mostafashaaban6767/Smart-Greenhouse-GroupA4/data/values used for calibration/DHT11.csv

real_temp | before_calibration_temp
8 | 10.5
26.7 | 27.6
26 | 26.2
