mostafashaaban6767/Smart-Greenhouse-GroupA4/data/values used for calibration/HX711.csv

raw | real_grams
-334720 | 0
-291830 | 109
-238760 | 226
-116510 | 566
