mostafashaaban6767/Smart-Greenhouse-GroupA4/data/values used for calibration/LDR.csv

raw_adc | real_lux
626 | 190
900 | 2400
341 | 10
600 | 90
