mostafashaaban6767/Smart-Greenhouse-GroupA4/data/values used for calibration/Soil Moisture.csv

raw_adc | real_wet_percentage
1006 | 0
602.5 | 100
