mostafashaaban6767/Smart-Greenhouse-GroupA4/data/values used for calibration/YF-S201.csv

total_pulses_to_fill_0.4L
152
142
165
