mostafashaaban6767/Smart-Greenhouse-GroupA4/docs/Greenhouse_Schematic.pdf

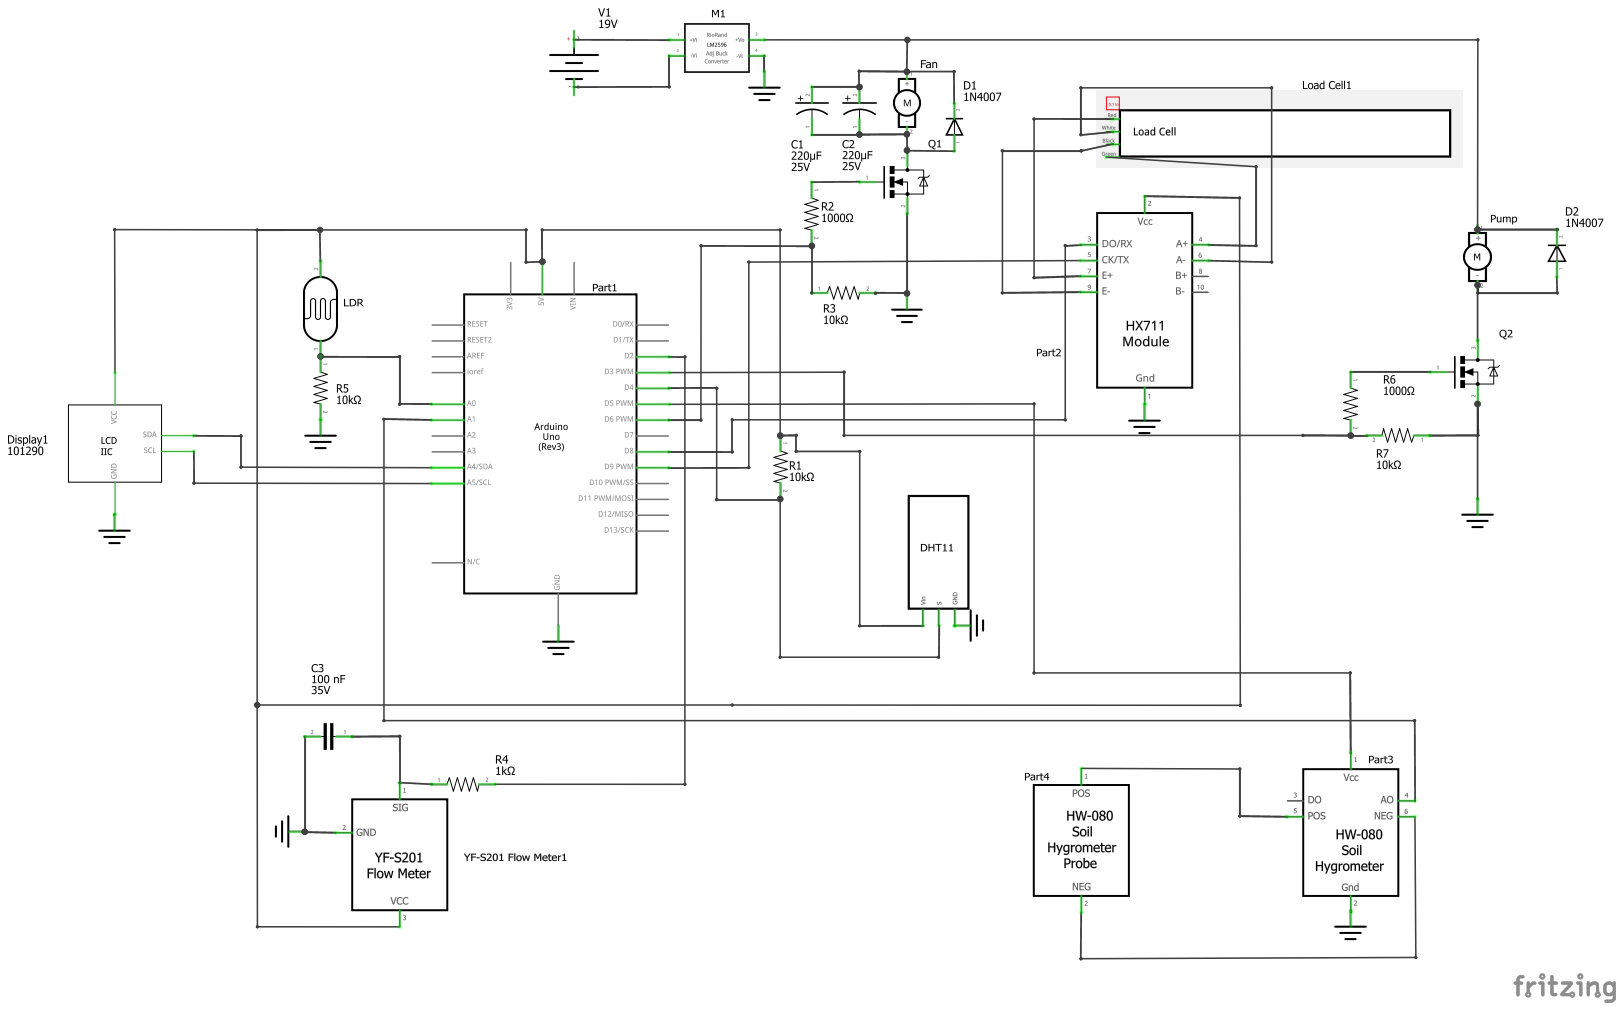
[picture p31: page 1]
