mostafashaaban6767/Smart-Greenhouse-GroupA4/code/GreenhouseCore/DHT11_Sensor.ino

void initDHT11() {
  dht.begin();
}

void readDHT11() {
  float t = dht.readTemperature();
  float h = dht.readHumidity();
  
  if (!isnan(t) && !isnan(h)) {
    currentTemp = getCalibratedTemperature(t);
    currentHum = getCalibratedHumidity(h);
  } else {
    currentTemp = NAN;
    currentHum = NAN;
  }
}
