mostafashaaban6767/Smart-Greenhouse-GroupA4/(commit log)

2026-07-04 Main and sensors ino files with calibration.h
2026-07-04 1-hour test run data and calibration reference values
    [DHT11.csv, HX711.csv, LDR.csv, Soil Moisture.csv, YF-S201.csv, greenhouse_run1hour.csv]
2026-07-04 Datasheets and Schematic
2026-07-05 Add bill of materials
